KaiPereira/Laser-Tag-SAO/PCB/Digikey BOM.csv

Reference | Qty | Value | DNP | Exclude from BOM | Exclude from Board | Exclude from Simulation | Exclude from Position Files | Footprint | Datasheet | Digikey Part #
BZ1 | 1 | Buzzer |  |  |  |  | ${EXCLUDE_FROM_POS_FILES} | Buzzer_Beeper:Buzzer_TDK_PS1240P02BT_D12.2mm_H6.5mm |  | 445-2525-1-ND - Cut Tape (CT)
C1 | 1 | 10uF |  |  |  |  | ${EXCLUDE_FROM_POS_FILES} | Capacitor_THT:C_Disc_D5.0mm_W2.5mm_P2.50mm |  | 445-173132-1-ND - Cut Tape (CT)
D1 | 1 | VSLY5940 |  |  |  |  | ${EXCLUDE_FROM_POS_FILES} | LED_THT:LED_D5.0mm |  | VSLY5940-ND
D2,D3,D4 | 3 | WS2812B-4020 |  |  |  |  | ${EXCLUDE_FROM_POS_FILES} | kai's library:LED_WS2812B-4020
J1 | 1 | SAO Connector |  |  |  |  | ${EXCLUDE_FROM_POS_FILES} | Connector_PinHeader_2.54mm:PinHeader_2x03_P2.54mm_Vertical |  | 35-PRPC003DAAN-RC-ND
JP1,JP2 | 2 | Jumper_2_Open |  |  |  |  | ${EXCLUDE_FROM_POS_FILES} | Jumper:SolderJumper-2_P1.3mm_Open_RoundedPad1.0x1.5mm
Q1 | 1 | PN2222A |  |  |  |  | ${EXCLUDE_FROM_POS_FILES} | Package_TO_SOT_THT:TO-92_Inline | https://www.onsemi.com/pub/Collateral/PN2222-D.PDF | 1514-PN2222APBFREE-ND
R1 | 1 | 22 |  |  |  |  | ${EXCLUDE_FROM_POS_FILES} | Resistor_THT:R_Axial_DIN0204_L3.6mm_D1.6mm_P5.08mm_Horizontal |  | CF18JT22R0TR-ND - Tape & Reel (TR)
R2 | 1 | 1k |  |  |  |  | ${EXCLUDE_FROM_POS_FILES} | Resistor_THT:R_Axial_DIN0204_L3.6mm_D1.6mm_P5.08mm_Horizontal |  | CF18JT1K00TR-ND - Tape & Reel (TR)
R4 | 1 | 10k |  |  |  |  | ${EXCLUDE_FROM_POS_FILES} | Resistor_THT:R_Axial_DIN0204_L3.6mm_D1.6mm_P5.08mm_Horizontal |  | CF18JT10K0TR-ND - Tape & Reel (TR)
SW1,SW2 | 2 | SW_Push |  |  |  |  | ${EXCLUDE_FROM_POS_FILES} | Button_Switch_THT:SW_PUSH_6mm |  | 450-1650-ND
U1 | 1 | ATTINY84A-PU |  |  |  |  | ${EXCLUDE_FROM_POS_FILES} | Package_DIP:DIP-14_W7.62mm | http://ww1.microchip.com/downloads/en/DeviceDoc/doc8006.pdf | ATTINY84A-PU-ND
U2 | 1 | TSOP38438 |  |  |  |  | ${EXCLUDE_FROM_POS_FILES} | OptoDevice:Vishay_MINICAST-3Pin | http://www.vishay.com/docs/82491/tsop382.pdf | TSOP38438-ND
U3 | 1 | OLED_0.91_128x32 |  |  |  |  | ${EXCLUDE_FROM_POS_FILES} | Hackclub Footprints:OLED_0.91_128x32 | https://www.buydisplay.com/download/manual/ER-OLEDM0.91-1_Datasheet.pdf
