KaiPereira/Laser-Tag-SAO/PCB/production/bom.csv

Designator | Footprint | Quantity | Value | LCSC Part #
BZ1 | Buzzer_TDK_PS1240P02BT_D12.2mm_H6.5mm | 1 | Buzzer
C1 | C_Disc_D5.0mm_W2.5mm_P2.50mm | 1 | 10uF
D1 | LED_D5.0mm | 1 | VSLY5940
D2, D3, D4 | LED_WS2812B-4020 | 3 | WS2812B-4020
J1 | PinHeader_2x03_P2.54mm_Vertical | 1 | SAO Connector
JP1, JP2 | SolderJumper-2_P1.3mm_Open_RoundedPad1.0x1.5mm | 2 | Jumper_2_Open
Q1 | TO-92_Inline | 1 | PN2222A
R1 | R_Axial_DIN0204_L3.6mm_D1.6mm_P5.08mm_Horizontal | 1 | 22
R2 | R_Axial_DIN0204_L3.6mm_D1.6mm_P5.08mm_Horizontal | 1 | 1k
R4 | R_Axial_DIN0204_L3.6mm_D1.6mm_P5.08mm_Horizontal | 1 | 10k
SW1, SW2 | SW_PUSH_6mm | 2 | SW_Push
U1 | DIP-14_W7.62mm | 1 | ATTINY84A-PU
U2 | Vishay_MINICAST-3Pin | 1 | TSOP38438
U3 | OLED_0.91_128x32 | 1 | OLED_0.91_128x32
