KaiPereira/Laser-Tag-SAO/PCB/laser-tag-sao.pdf

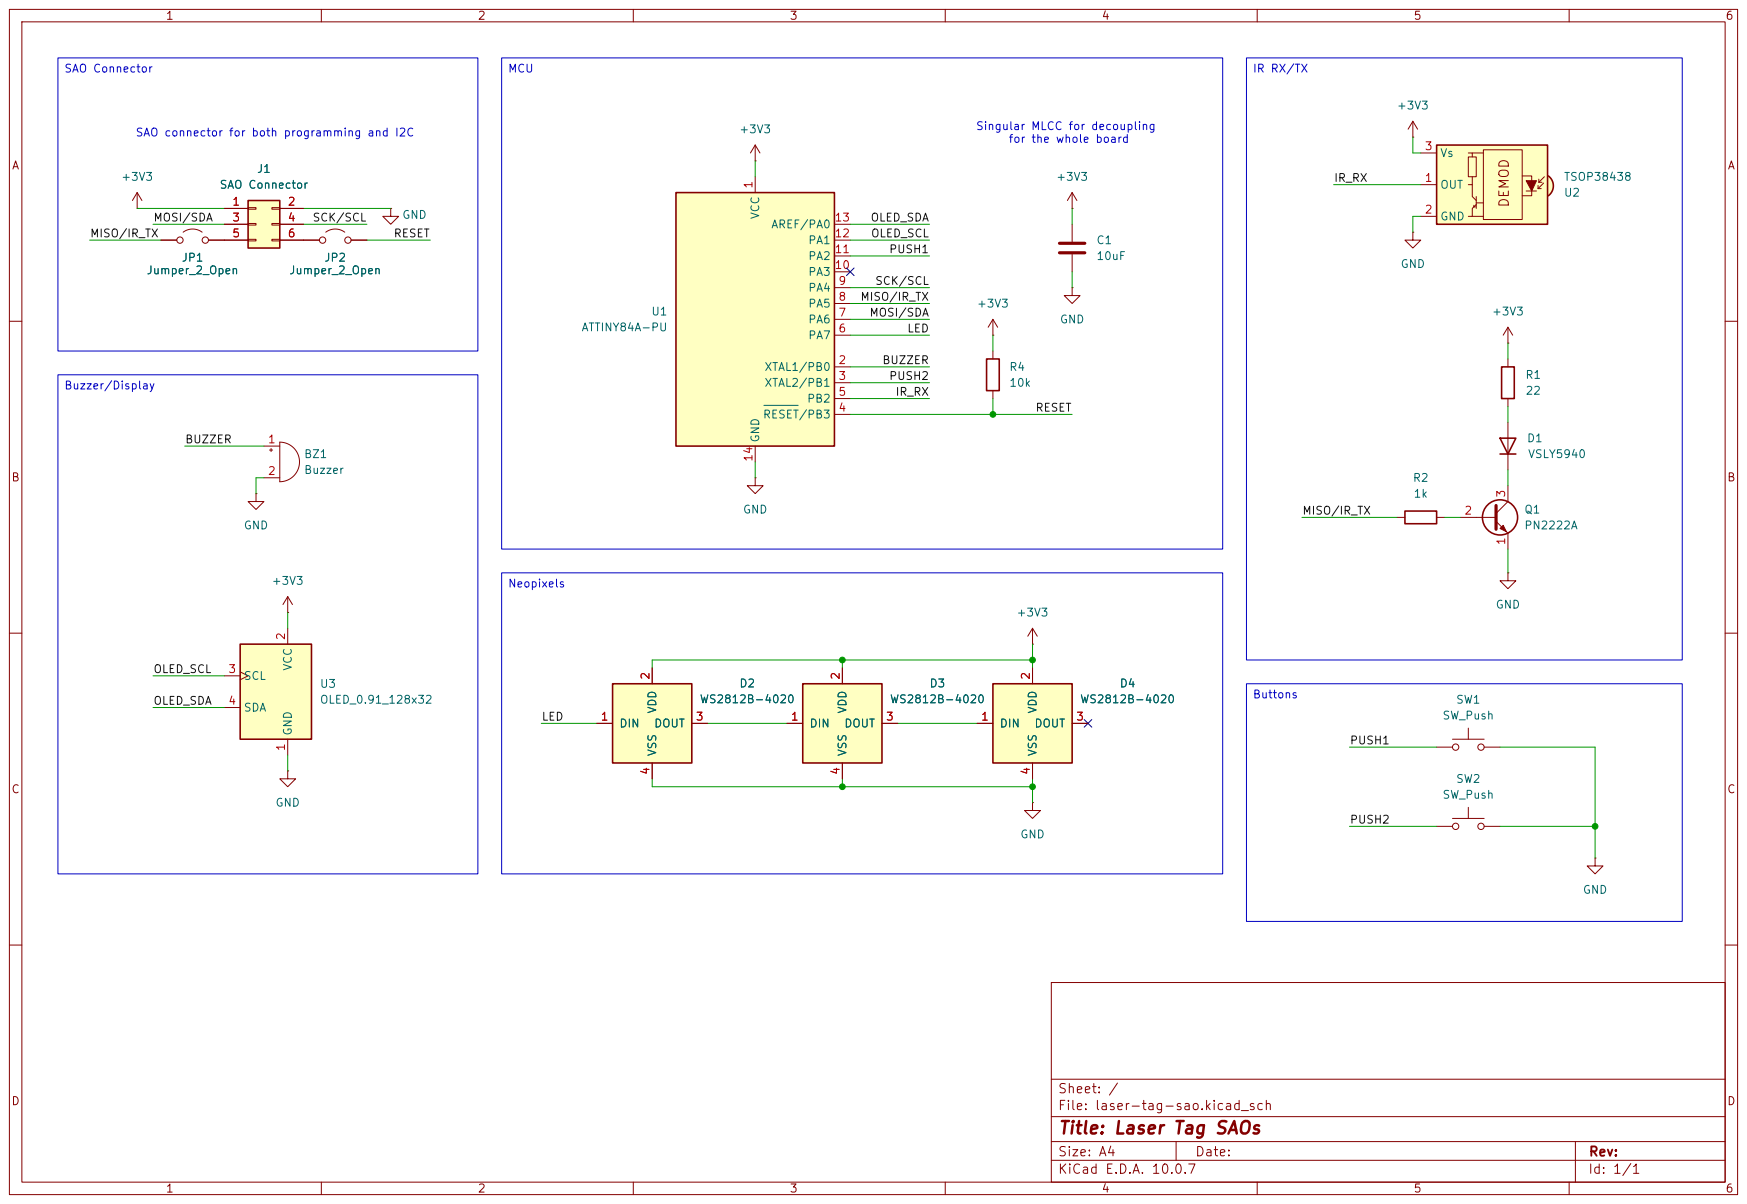
[picture p1: page 1]

for the whole board
IR_RX OLED_SCL SCK/SCL
MISO/IR_TX PUSH1

Sheet: /
File: laser-tag-sao.kicad_sch
Title: Laser Tag SAOs

Size: A4 | Rev:
KiCad E.D.A. 10.0.7 | Id: 1/1
