KaiPereira/Laser-Tag-SAO/PCB/laser-tag-sao.kicad_pcb

## KiCad design PCB/laser-tag-sao.kicad_pcb (2026-10-20)

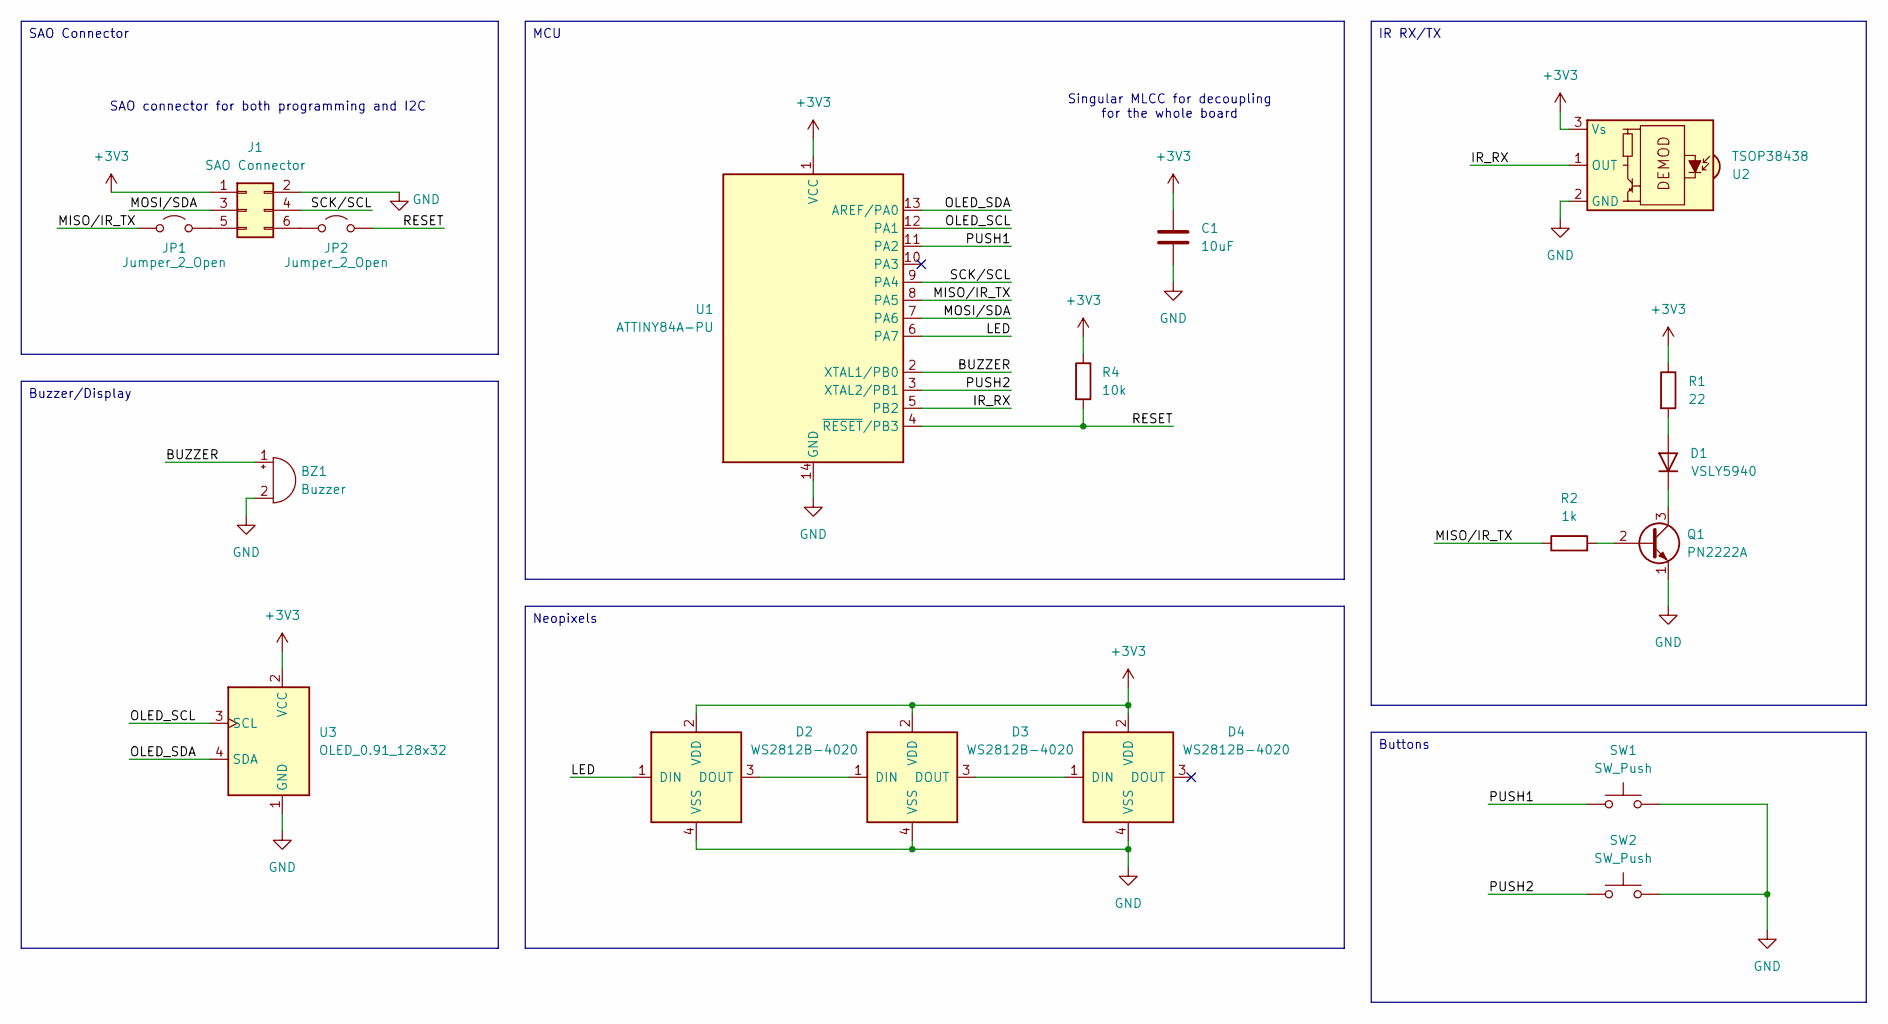
[picture p2: schematic laser-tag-sao.kicad_sch, Laser Tag SAOs]

Parts:
BZ1: Buzzer; Buzzer_TDK_PS1240P02BT_D12.2mm_H6.5mm; Digikey Part # 445-2525-1-ND - Cut Tape (CT)
C1: 10uF; C_Disc_D5.0mm_W2.5mm_P2.50mm; Digikey Part # 445-173132-1-ND - Cut Tape (CT)
D1: VSLY5940; LED_D5.0mm; Digikey Part # VSLY5940-ND
D2, D3, D4: WS2812B-4020; LED_WS2812B-4020; PARTREV V1.2
J1: SAO Connector; PinHeader_2x03_P2.54mm_Vertical
JP1, JP2: Jumper_2_Open; SolderJumper-2_P1.3mm_Open_RoundedPad1.0x1.5mm
Q1: PN2222A; TO-92_Inline
R1: 22; R_Axial_DIN0204_L3.6mm_D1.6mm_P5.08mm_Horizontal; Digikey Part # CF18JT22R0TR-ND - Tape & Reel (TR)
R2: 1k; R_Axial_DIN0204_L3.6mm_D1.6mm_P5.08mm_Horizontal; Digikey Part # CF18JT1K00TR-ND - Tape & Reel (TR)
R4: 10k; R_Axial_DIN0204_L3.6mm_D1.6mm_P5.08mm_Horizontal; Digikey Part # CF18JT10K0TR-ND - Tape & Reel (TR)
SW1: SW_Push; SW_PUSH_6mm; Digikey Part # 450-1650-ND
SW2: SW_Push; SW_PUSH_6mm
U1: ATTINY84A-PU; DIP-14_W7.62mm; Digikey Part # ATTINY84A-PU-ND
U2: TSOP38438; Vishay_MINICAST-3Pin; Digikey Part # TSOP38438-ND
U3: OLED_0.91_128x32

Connections:
+3V3: C1.1, D2.2 (VDD), D3.2 (VDD), D4.2 (VDD), J1.1, R1.1, R4.1, U1.1 (VCC), U2.3 (Vs), U3.2 (VCC)
/BUZZER: BZ1.1 (+), U1.2 (XTAL1/PB0)
/IR_RX: U1.5 (PB2), U2.1 (OUT)
/LED: D2.1 (DIN), U1.6 (PA7)
/MISO/IR_TX: JP1.1 (A), R2.1, U1.8 (PA5)
/MOSI/SDA: J1.3, U1.7 (PA6)
/OLED_SCL: U1.12 (PA1), U3.3 (SCL)
/OLED_SDA: U1.13 (AREF/PA0), U3.4 (SDA)
/PUSH1: SW1.1, U1.11 (PA2)
/PUSH2: SW2.1, U1.3 (XTAL2/PB1)
/RESET: JP2.2 (B), R4.2, U1.4 (~RESET/PB3)
/SCK/SCL: J1.4, U1.9 (PA4)
GND: BZ1.2 (-), C1.2, D2.4 (VSS), D3.4 (VSS), D4.4 (VSS), J1.2, Q1.1 (E), SW1.2, SW2.2, U1.14 (GND), U2.2 (GND), U3.1 (GND)
unnamed: D1.2 (A), R1.2
unnamed: D1.1 (K), Q1.3 (C)
unnamed: D2.3 (DOUT), D3.1 (DIN)
unnamed: D3.3 (DOUT), D4.1 (DIN)
unnamed: J1.5, JP1.2 (B)
unnamed: J1.6, JP2.1 (A)
unnamed: Q1.2 (B), R2.2

Notes on the sheet:
SAO connector for both programming and I2C
Singular MLCC for decoupling for the whole board
IR RX/TX
Neopixels
Buzzer/Display
Buttons
SAO Connector
MCU

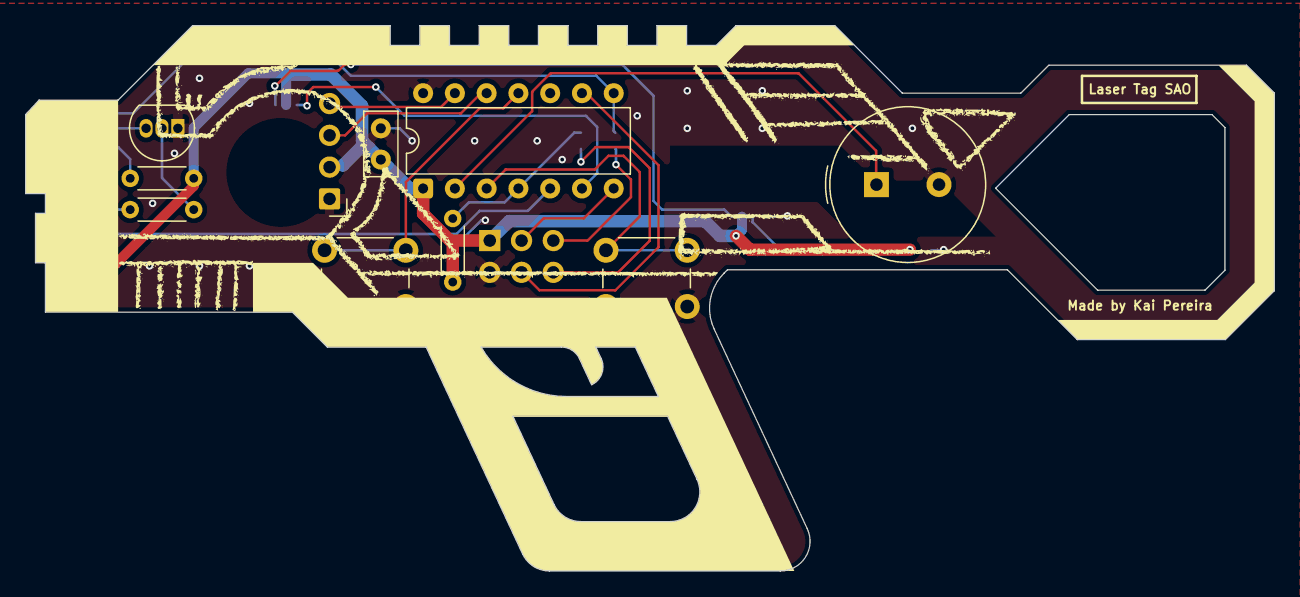
[picture p3: board laser-tag-sao.kicad_pcb from above]

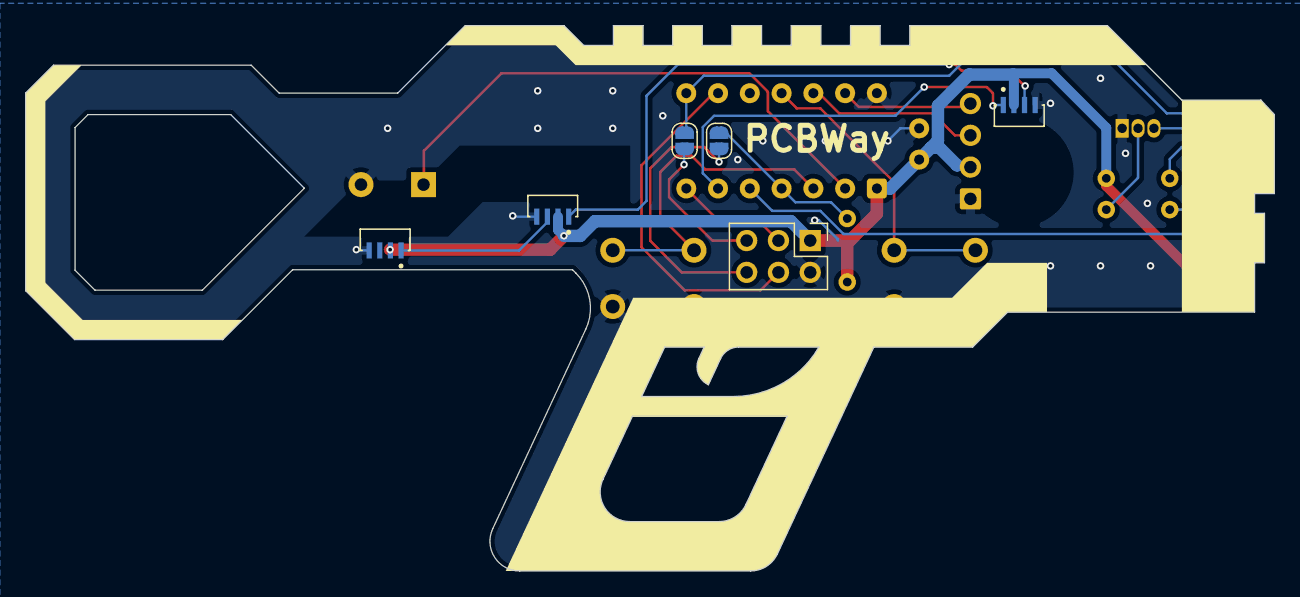
[picture p4: board laser-tag-sao.kicad_pcb from below]

Board: 2 copper layers, 99.8 x 43.6 mm, 18 parts (6 on the bottom side), 20 nets.
