KaiPereira/Laser-Tag-SAO/(commit log)

2026-10-16 init PCB
2026-10-19 almost done schematic!
2026-10-19 finished schematic
2026-10-19 updating schematic again
2026-10-19 adding in all the footprints
2026-10-20 laying out components on my board
2026-10-20 adding neopixels and soldermask openings
2026-10-20 finished routing the board, 0 DRC errors
2026-10-20 removing silkscreen designators
2026-10-20 adding silkscreen
2026-10-20 cleaning up the ground fill a bit
2026-10-20 adding PCBWay branding
2026-10-22 adding digikey BOM
2026-10-22 new digikey BOM
2026-10-22 updating BOM
2026-11-06 adding arduinoISP code
2026-11-06 adding laser tag code and putting ino's in folders
2026-11-07 most recent laser tag code ;D
